e-asphyx/usb_dac/board.pdf

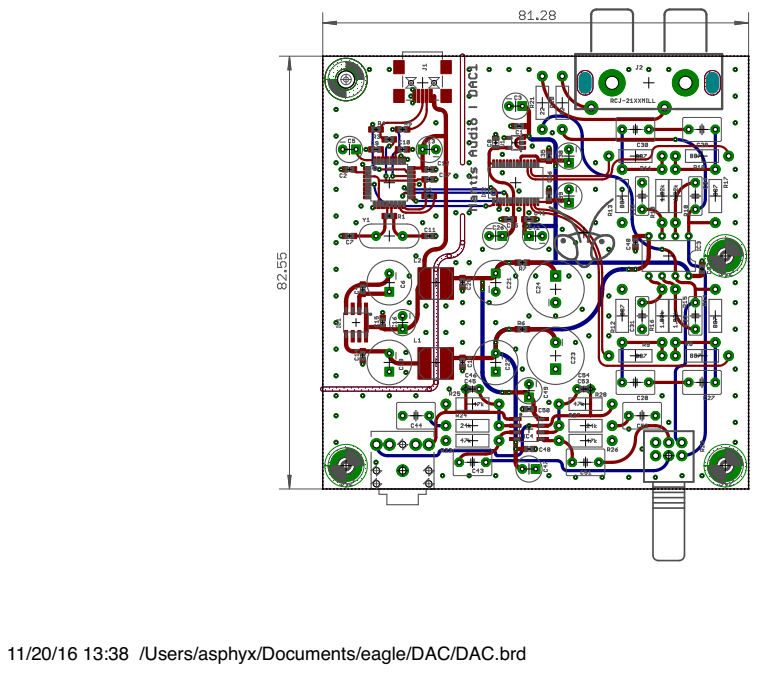
[picture p1: page 1]

11/20/16 13:38 /Users/asphyx/Documents/eagle/DAC/DAC.brd
