e-asphyx/usb_dac/DAC.pdf

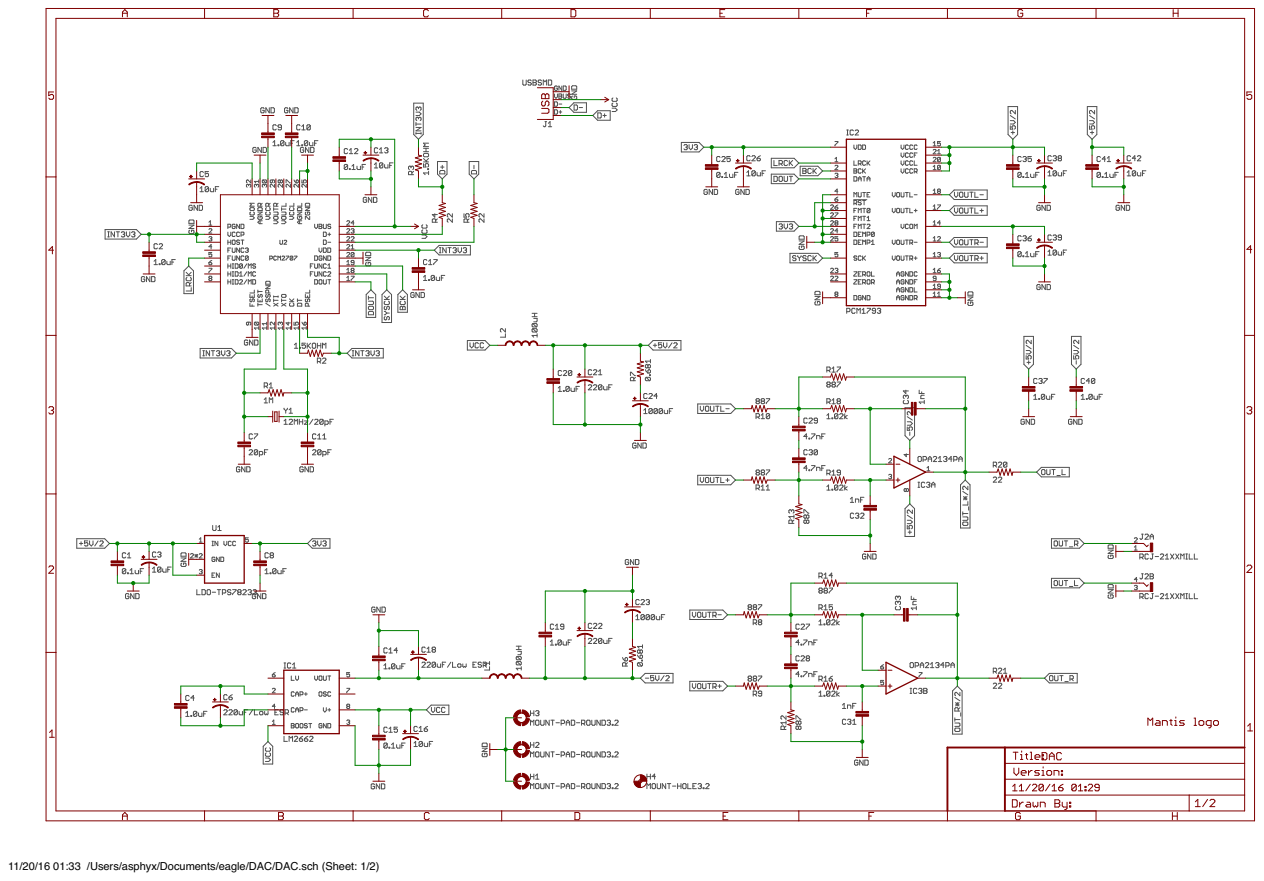
[picture p2: page 1]

11/20/16 01:33 /Users/asphyx/Documents/eagle/DAC/DAC.sch (Sheet: 1/2)

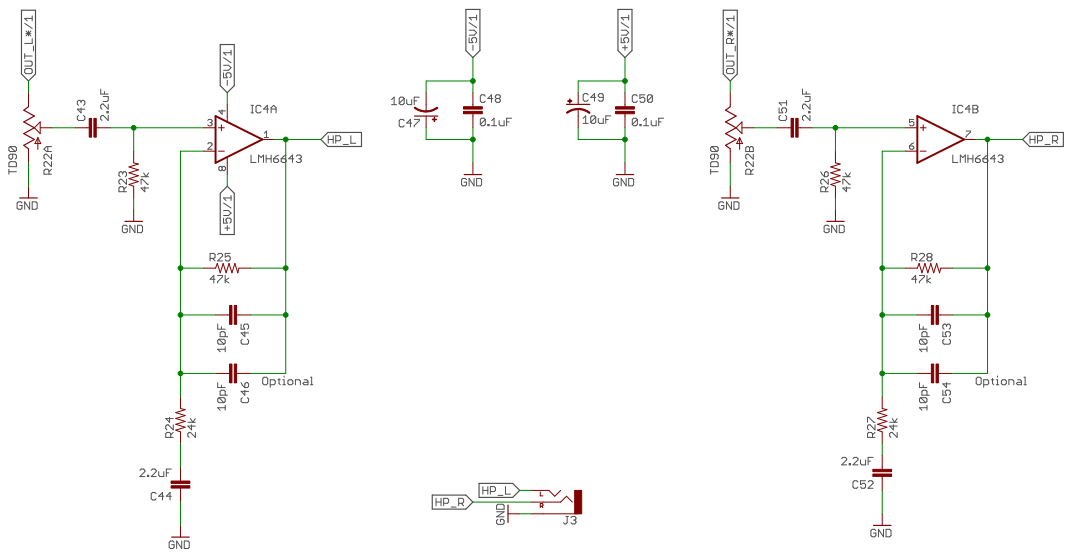
[picture p3: page 2]

11/20/16 01:33 /Users/asphyx/Documents/eagle/DAC/DAC.sch (Sheet: 2/2)
