e-asphyx/usb_dac/DAC.brd

## EAGLE design DAC.brd (2016-11-20)

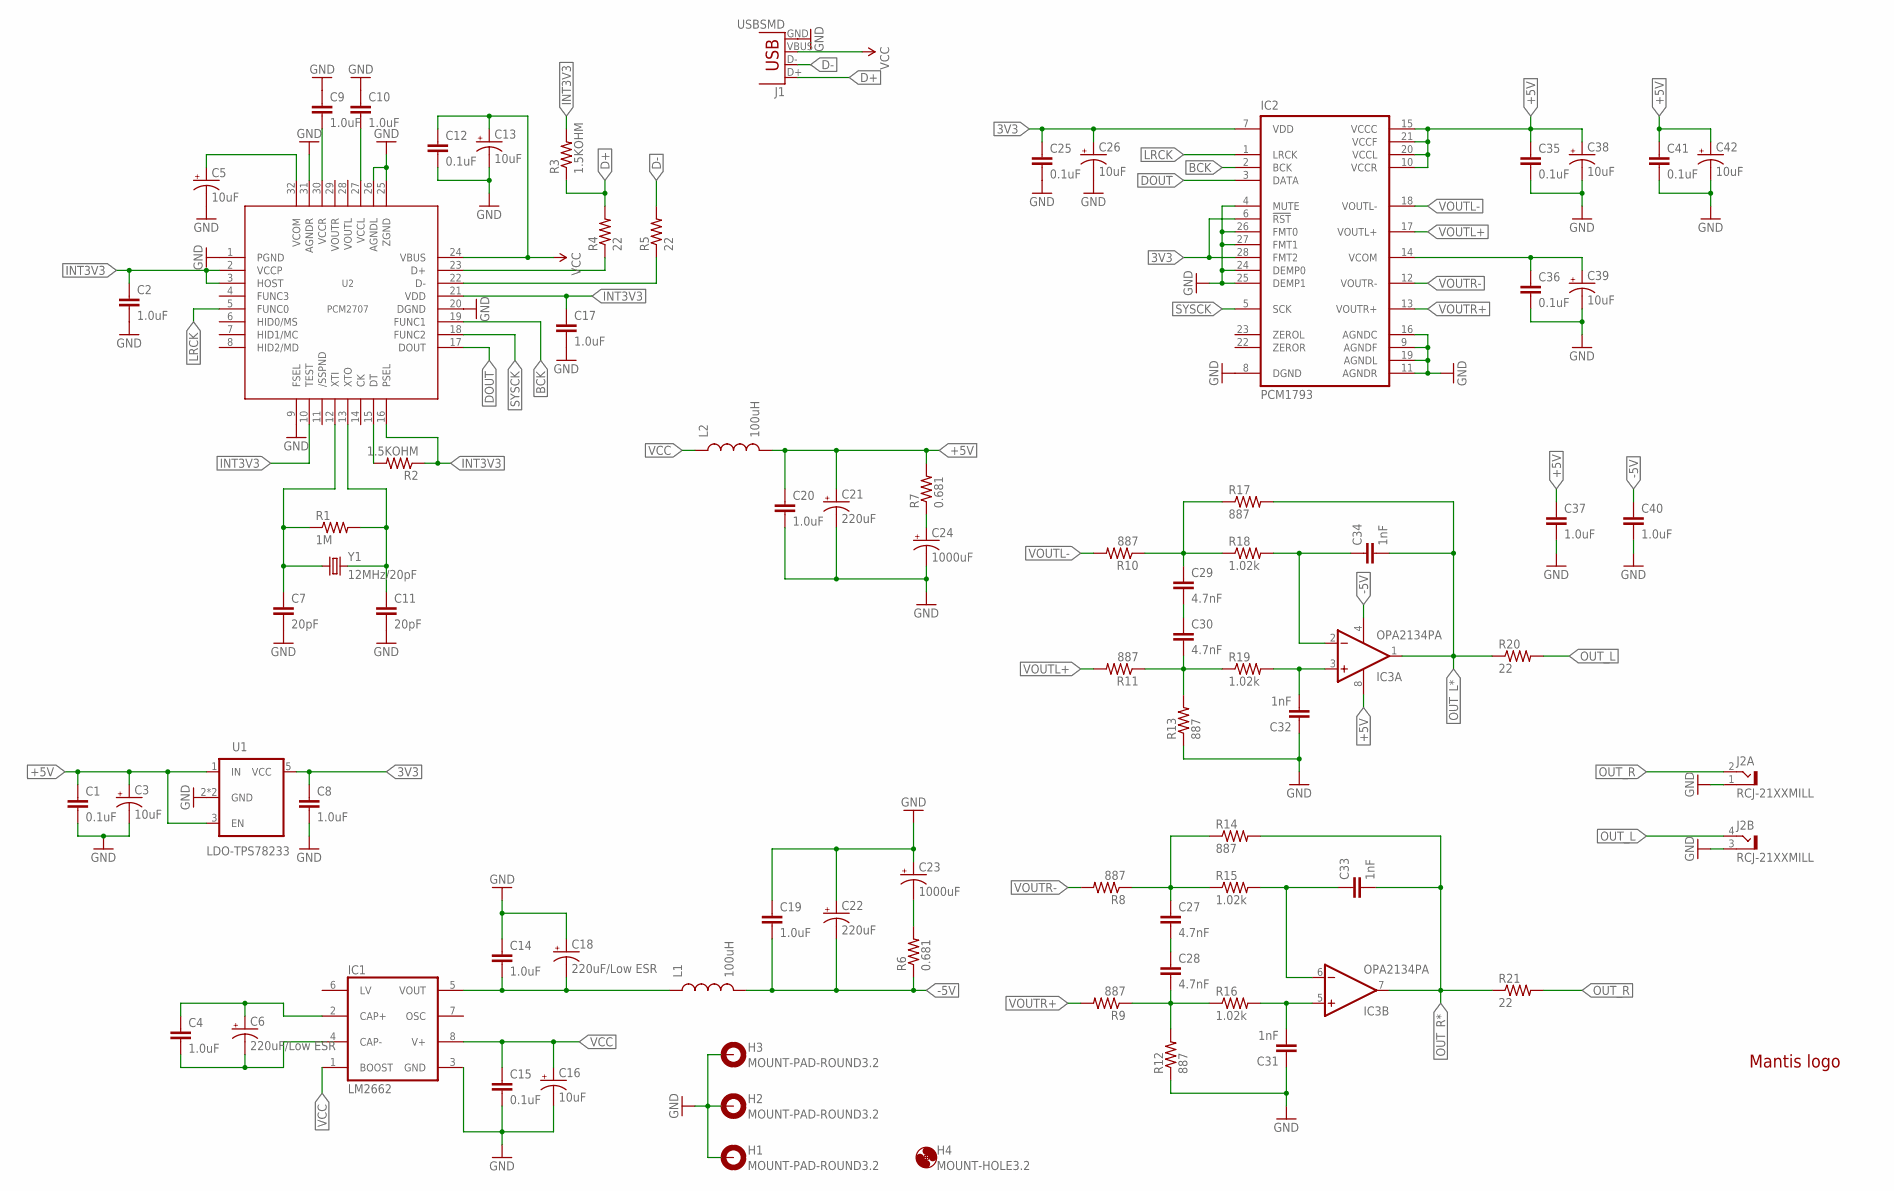
[picture p4: schematic DAC.sch, sheet 1]

Parts:
C1, C12, C15, C25, C35, C36, C41: 0.1uF; 0603-CAP
C2, C4, C9, C10, C14, C17, C19, C20, C37, C40: 1.0uF; 0603-CAP
C3, C5, C13, C16, C26, C38, C39, C42: 10uF; CPOL-RADIAL-10UF-25V
C6, C18: 220uF/Low ESR; CPOL-RADIAL-8/3.5
C7, C11: 20pF; 0603-CAP
C8: 1.0uF; 0805-CAP
C21, C22: 220uF; CPOL-RADIAL-8/3.5
C23, C24: 1000uF; CPOL-RADIAL-1000UF-25V
C27, C28, C29, C30: 4.7nF; C5B4.5
C31, C32, C33, C34: 1nF; C5B2.5
H1, H2, H3: MOUNT-PAD-ROUND3.2; 3,2-PAD
H4: MOUNT-HOLE3.2; 3,2
IC1: LM2662; SO08
IC2: PCM1793; SSOP28BU
IC3: OPA2134PA; DIL08
J1: USBSMD; USB-MINIB
J2: RCJ-21XXMILL; RCJ-21-MILL
L1, L2: 100uH; SRN6045; MOUSER_ID 652-SRN6045-101M
LOGO1: LOGO-MANTIS
R1: 1M; 0603-RES
R2, R3: 1.5KOHM; 0603
R4, R5: 22; 0603-RES
R6, R7: 0.681; 0603-RES
R8, R9, R10, R11, R12, R13, R14, R17: 887; AXIAL-0.4
R15, R16, R18, R19: 1.02k; AXIAL-0.4
R20, R21: 22; AXIAL-0.4
U1: LDO-TPS78233; SOT23-5
U2: PCM2707; TQFP32-08
Y1: 12MHz/20pF; HC49US; MOUSER_ID 73-XT49S1200-20

Connections:
3V3: C8.1, C25.1, C26.1 (+), IC2.6 (!RST), IC2.7 (VDD), IC2.28 (FMT2), U1.5 (VCC)
+5V: C1.1, C3.1 (+), C20.1, C21.1 (+), C35.1, C37.1, C38.1 (+), C41.1, C42.1 (+), IC2.10 (VCCR), IC2.15 (VCCC), IC2.20 (VCCL), IC2.21 (VCCF), IC3.8 (V+), L2.2, R7.2, U1.1 (IN), U1.3 (EN); also elsewhere on the board
-5V: C19.2, C22.2 (-), C40.1, IC3.4 (V-), L1.2, R6.1; also elsewhere on the board
BCK: IC2.2 (BCK), U2.19 (FUNC1)
D+: J1.D+, R3.1, R4.2
D+*: R4.1, U2.23 (D+)
D-: J1.D-, R5.2
D-*: R5.1, U2.22 (D-)
DOUT: IC2.3 (DATA), U2.17 (DOUT)
GND: C1.2, C2.2, C3.2 (-), C5.2 (-), C7.2, C8.2, C9.1, C10.1, C11.2, C12.2, C13.2 (-), C14.1, C15.2, C16.2 (-), C17.2, C18.1 (+), C19.1, C20.2, C21.2 (-), C22.1 (+), C23.+, C24.-, C25.2, C26.2 (-), C31.1, C32.1, C35.2, C36.2, C37.2, C38.2 (-), C39.2 (-), C40.2, C41.2, C42.2 (-), H1.B3,2, H2.B3,2, H3.B3,2, IC1.3 (GND), IC2.4 (MUTE), IC2.8 (DGND), IC2.9 (AGNDF), IC2.11 (AGNDR), IC2.16 (AGNDC), IC2.19 (AGNDL), IC2.24 (DEMP0), IC2.25 (DEMP1), IC2.26 (FMT0), IC2.27 (FMT1), J1.GND, J2.1 (S), J2.3 (S), R12.P$1 (1), R13.P$1 (1), U1.2 (GND), U1.4 (GND), U2.1 (PGND), U2.9 (FSEL), U2.20 (DGND), U2.25 (ZGND), U2.26 (AGNDL), U2.31 (AGNDR); also elsewhere on the board
INT3V3: C2.1, C17.1, R2.1, R3.2, U2.2 (VCCP), U2.3 (HOST), U2.10 (TEST), U2.16 (PSEL), U2.21 (VDD)
LRCK: IC2.1 (LRCK), U2.5 (FUNC0)
unnamed: R2.2, U2.15 (DT)
unnamed: C5.1 (+), U2.32 (VCOM)
unnamed: C9.2, U2.30 (VCCR)
unnamed: C10.2, U2.27 (VCCL)
unnamed: C36.1, C39.1 (+), IC2.14 (VCOM)
unnamed: C24.+, R7.1
unnamed: C14.2, C18.2 (-), IC1.5 (VOUT), L1.1
unnamed: C23.-, R6.2
unnamed: C4.1, C6.1 (+), IC1.2 (CAP+)
unnamed: C4.2, C6.2 (-), IC1.4 (CAP-)
unnamed: C29.2, C30.1
unnamed: C30.2, R11.P$1 (1), R13.P$2 (2), R19.P$1 (1)
unnamed: C29.1, R10.P$1 (1), R17.P$1 (1), R18.P$1 (1)
unnamed: C28.2, R9.P$1 (1), R12.P$2 (2), R16.P$1 (1)
unnamed: C27.1, R8.P$1 (1), R14.P$1 (1), R15.P$1 (1)
unnamed: C27.2, C28.1
OPL+: C32.2, IC3.3 (+IN), R19.P$2 (2)
OPL-: C34.1, IC3.2 (-IN), R18.P$2 (2)
OPR+: C31.2, IC3.5 (+IN), R16.P$2 (2)
OPR-: C33.1, IC3.6 (-IN), R15.P$2 (2)
OUT_L: J2.4 (T), R20.P$2 (2)
OUT_L*: C34.2, IC3.1 (OUT), R17.P$2 (2), R20.P$1 (1); also elsewhere on the board
OUT_R: J2.2 (T), R21.P$2 (2)
OUT_R*: C33.2, IC3.7 (OUT), R14.P$2 (2), R21.P$1 (1); also elsewhere on the board
SYSCK: IC2.5 (SCK), U2.18 (FUNC2)
VCC: C12.1, C13.1 (+), C15.1, C16.1 (+), IC1.1 (BOOST), IC1.8 (V+), J1.VBUS, L2.1, U2.24 (VBUS)
VOUTL+: IC2.17 (VOUTL+), R11.P$2 (2)
VOUTL-: IC2.18 (VOUTL-), R10.P$2 (2)
VOUTR+: IC2.13 (VOUTR+), R9.P$2 (2)
VOUTR-: IC2.12 (VOUTR-), R8.P$2 (2)
XTI: C7.1, R1.1, U2.12 (XTI), Y1.1
XTO: C11.1, R1.2, U2.13 (XTO), Y1.2

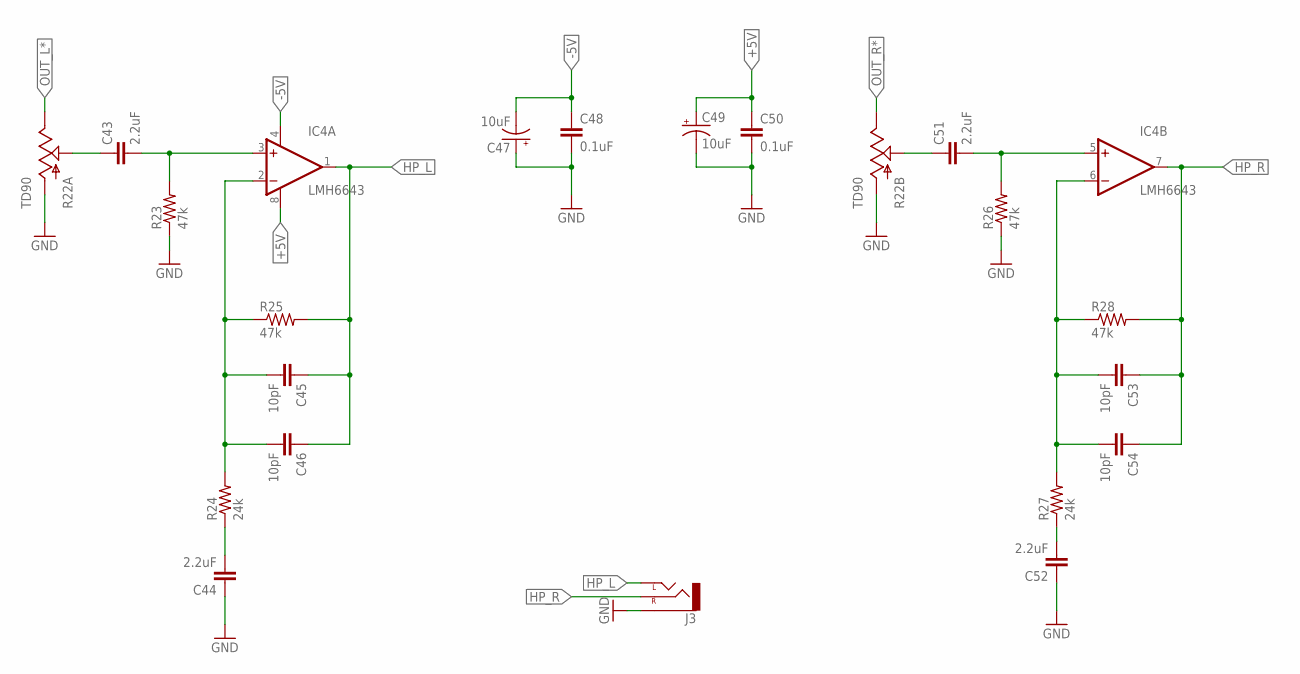
[picture p5: schematic DAC.sch, sheet 2]

Parts:
C43, C44, C51, C52: 2.2uF; C5B5
C45, C53: 10pF; CAP-PTH-SMALL
C46, C54: 10pF; 0603-CAP
C47, C49: 10uF; CPOL-RADIAL-10UF-25V
C48, C50: 0.1uF; 0603-CAP
IC4: LMH6643; SO08
J3: AUDIO-JACKPTH; AUDIO-JACK
R22: TD90; PTD902
R23, R25, R26, R28: 47k; AXIAL-0.4
R24, R27: 24k; AXIAL-0.4

Connections:
+5V: C49.1 (+), C50.1, IC4.8 (V+); also elsewhere on the board
-5V: C47.2 (-), C48.1, IC4.4 (V-); also elsewhere on the board
GND: C44.1, C47.1 (+), C48.2, C49.2 (-), C50.2, C52.1, J3.SLEEVE, R22.R1.1 (A), R22.R2.1 (A), R23.P$1 (1), R26.P$1 (1); also elsewhere on the board
HP_L: C45.1, C46.1, IC4.1 (OUT), J3.TIP (LEFT), R25.P$2 (2)
HP_R: C53.1, C54.1, IC4.7 (OUT), J3.RING (RIGHT), R28.P$2 (2)
unnamed: C45.2, C46.2, IC4.2 (-IN), R24.P$2 (2), R25.P$1 (1)
unnamed: C43.2, IC4.3 (+IN), R23.P$2 (2)
unnamed: C51.1, R22.R2.2 (S)
unnamed: C51.2, IC4.5 (+IN), R26.P$2 (2)
unnamed: C53.2, C54.2, IC4.6 (-IN), R27.P$2 (2), R28.P$1 (1)
unnamed: C43.1, R22.R1.2 (S)
unnamed: C52.2, R27.P$1 (1)
unnamed: C44.2, R24.P$1 (1)
OUT_L*: R22.R1.3 (E); also elsewhere on the board
OUT_R*: R22.R2.3 (E); also elsewhere on the board

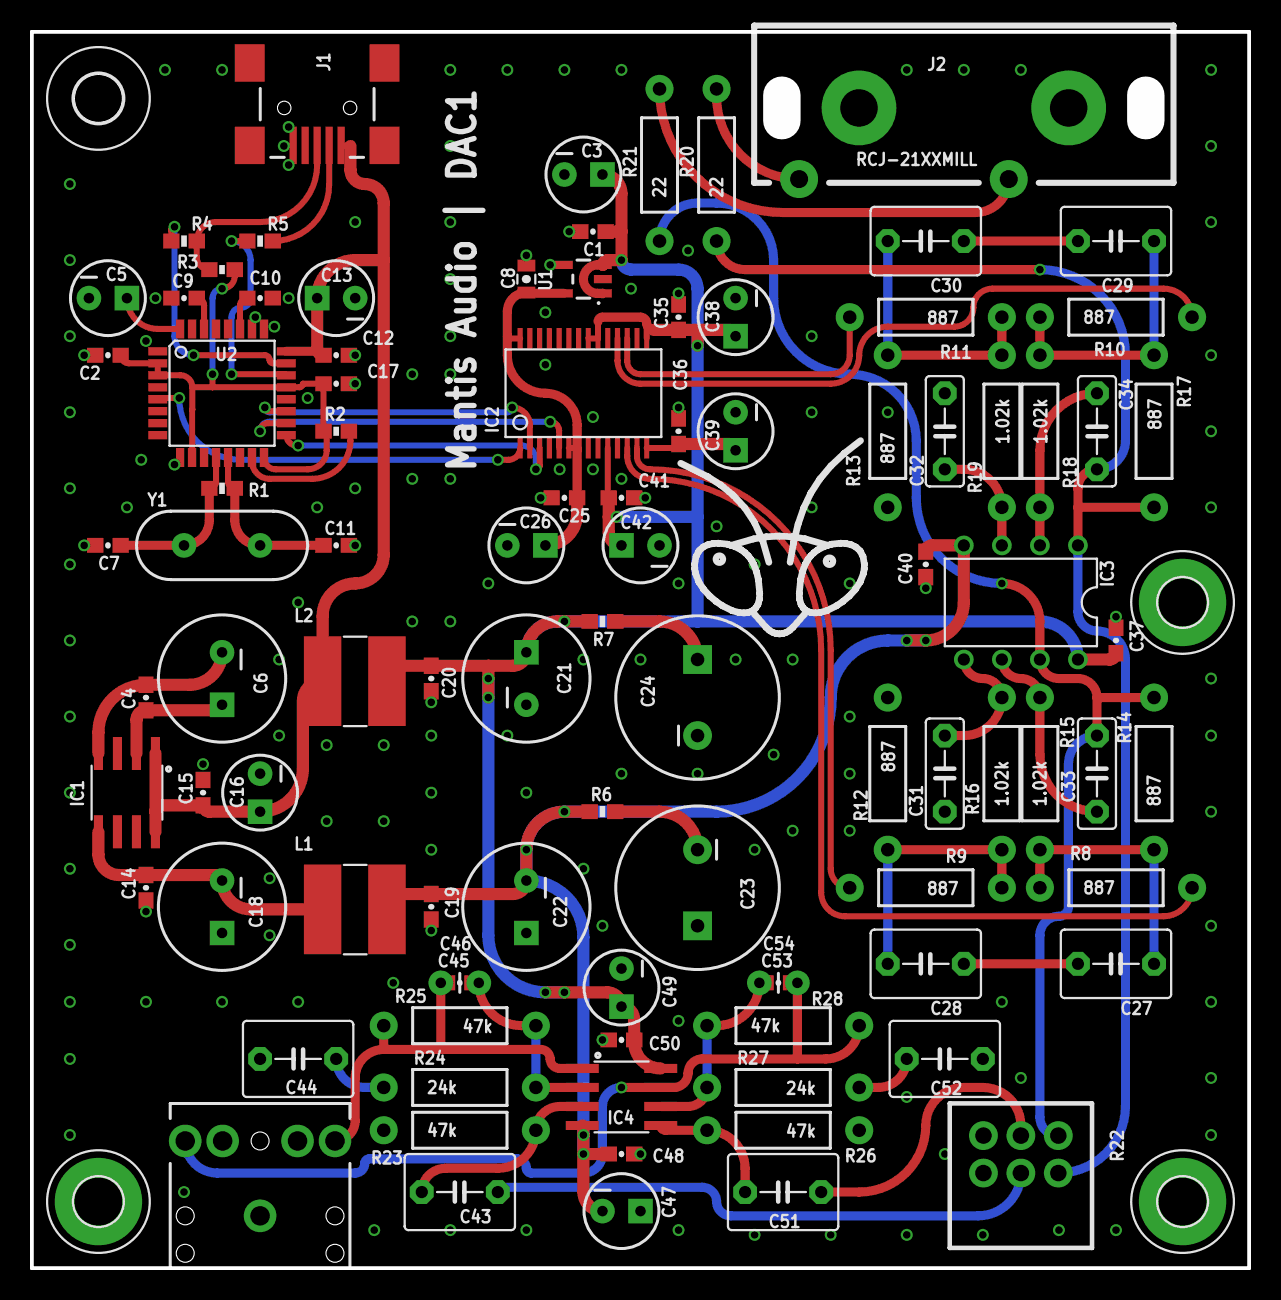
[picture p6: board DAC.brd from above]

Board: 2 copper layers, 81.3 x 82.5 mm, 99 parts (0 on the bottom side), 54 nets.
