e-asphyx/usb_dac/(commit log)

2016-10-12 Protection res
    [DAC.brd, DAC.sch]
2016-10-13 Some packages updated
    [DAC.brd, DAC.sch]
2016-10-13 Phone out
    [DAC.brd, DAC.sch]
2016-10-13 Bias correction
    [DAC.brd, DAC.sch]
2016-10-16 2.5mm jack was placed by mistake
    [DAC.brd, DAC.sch]
2016-11-03 Phone jack position adjusted
    [DAC.brd]
2016-11-03 Schematics prettyfied
    [DAC.sch]
2016-11-04 More decoupling
    [DAC.brd, DAC.sch]
2016-11-04 Caps footprint changed to more standard
    [DAC.brd, DAC.sch]
2016-11-06 Power op amp is AC coupled now to avoid bias current to pass through the pot
    [DAC.brd, DAC.sch]
2016-11-06 Mounting holes
    [DAC.brd, DAC.sch]
2016-11-18 DRU changed
    [DAC.brd]
2016-11-19 PCB layout closer to guidelines
    [DAC.brd, DAC.sch]
2016-11-20 Power rerouted
    [DAC.brd]
